thwise/kicad_tools/colour/pcbnew.png

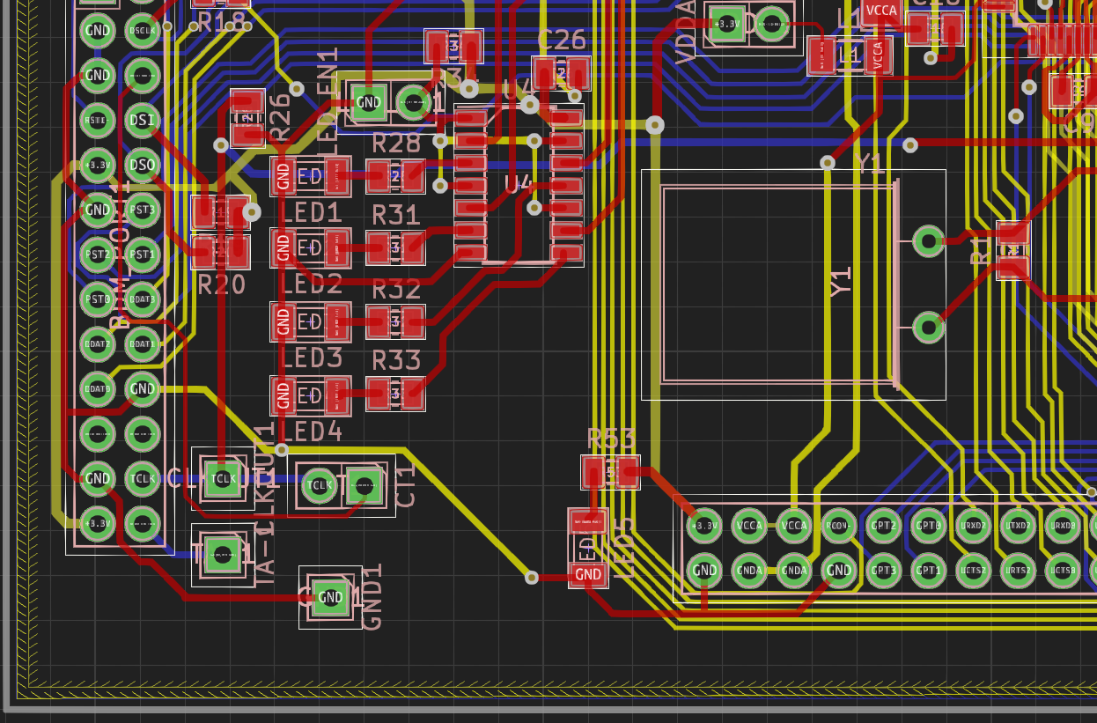
colour/pcbnew.png
