thwise/kicad_tools/colour/eeschema.png

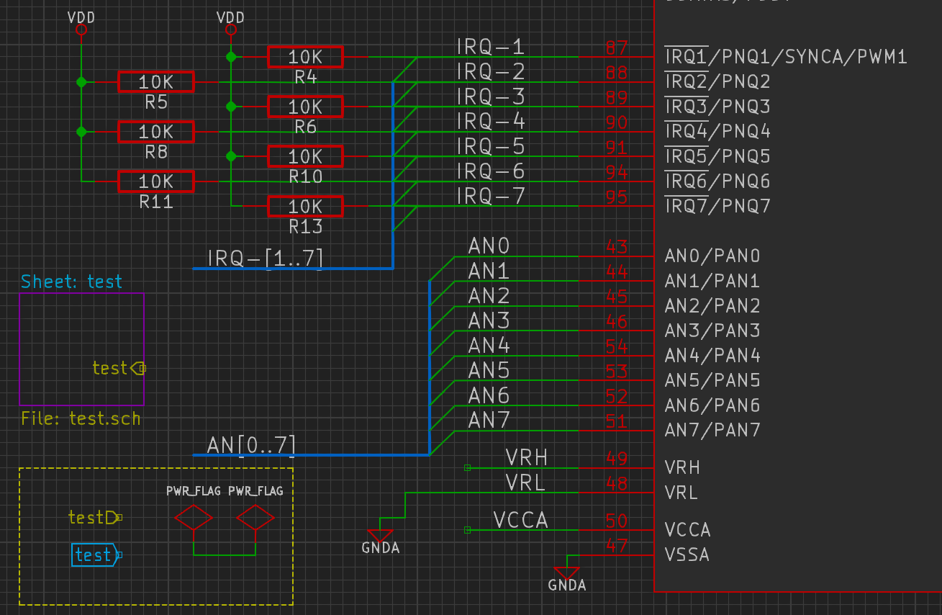
colour/eeschema.png
