thwise/kicad_tools/colour/footprint_editor.png

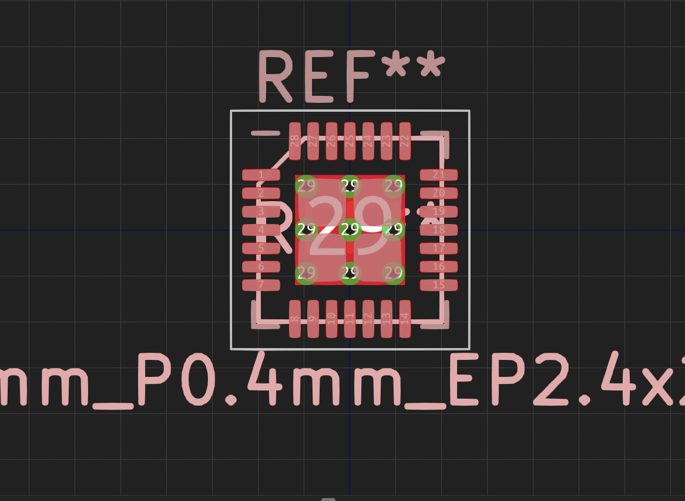
colour/footprint_editor.png
