thwise/kicad_tools/3DLib/TS-1101-C-W.stp

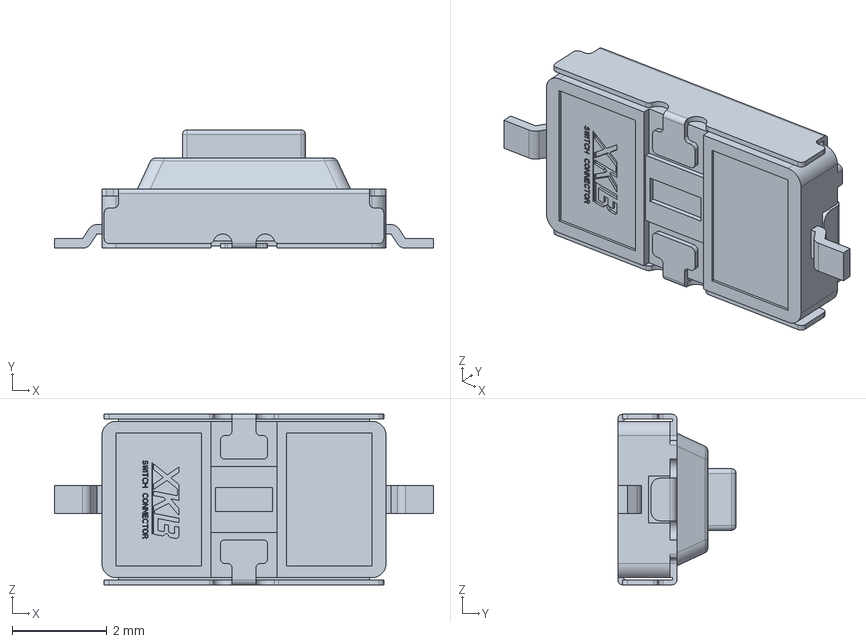
[picture p15: CAD file, 2023-06-17]
3DLib/TS-1101-C-W.stp
8.00 x 2.50 x 3.60 mm
