thwise/kicad_tools/3DLib/3362P-1-103.stp

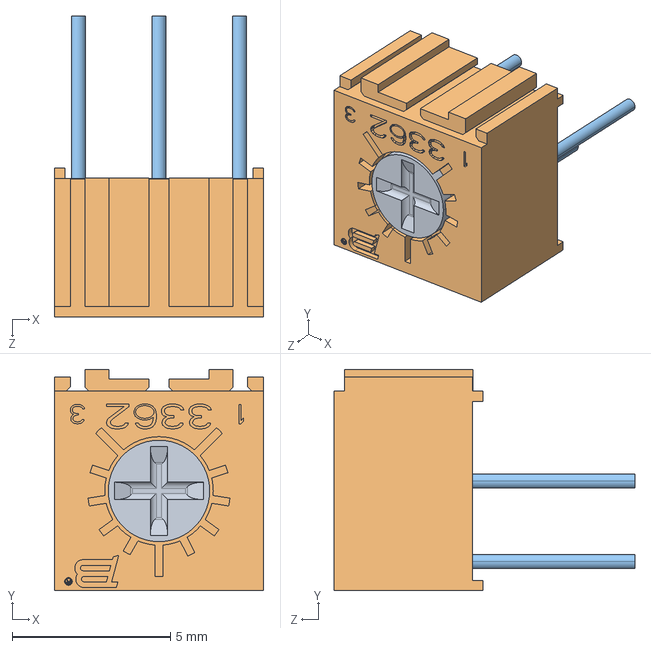
[picture p16: CAD file, 2023-06-17]
3DLib/3362P-1-103.stp
6.60 x 6.99 x 9.50 mm
