thwise/kicad_tools/3DLib/B4B-XH-A_LF__SN_.stp

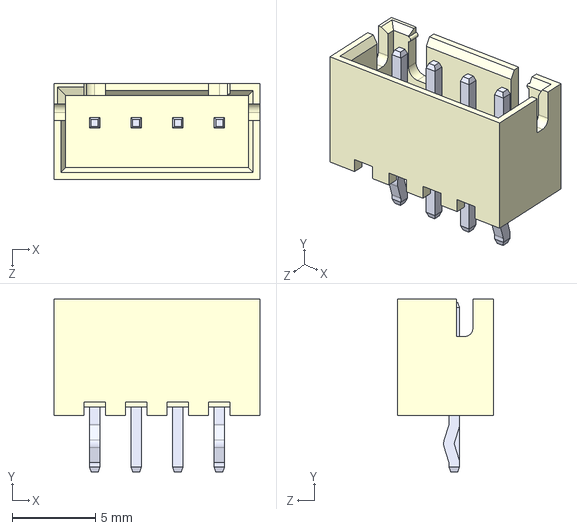
[picture p17: CAD file, 2023-06-17]
3DLib/B4B-XH-A_LF__SN_.stp
12.4 x 10.4 x 5.75 mm
B4B-XH-A(LF)(SN) - BODY
B4B-XH-A(LF)(SN) - PIN
