thwise/kicad_tools/3DLib/S8B-PH-SM4-TB_LF__SN_.stp

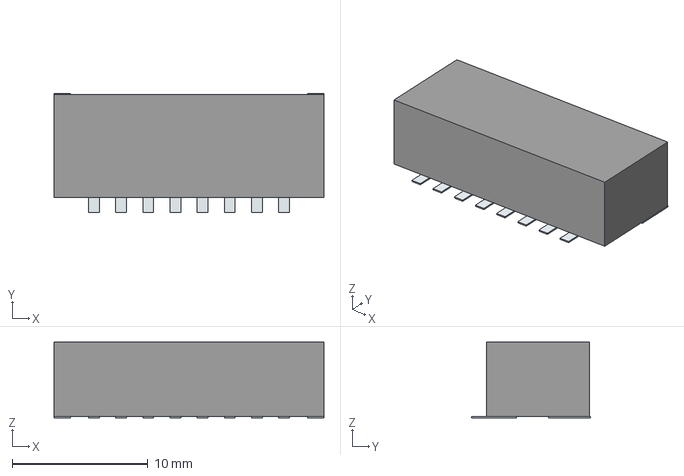
[picture p18: CAD file, 2023-06-17]
3DLib/S8B-PH-SM4-TB_LF__SN_.stp
19.9 x 8.75 x 5.60 mm
Pins
