thwise/kicad_tools/3DLib/S8411-45R.stp

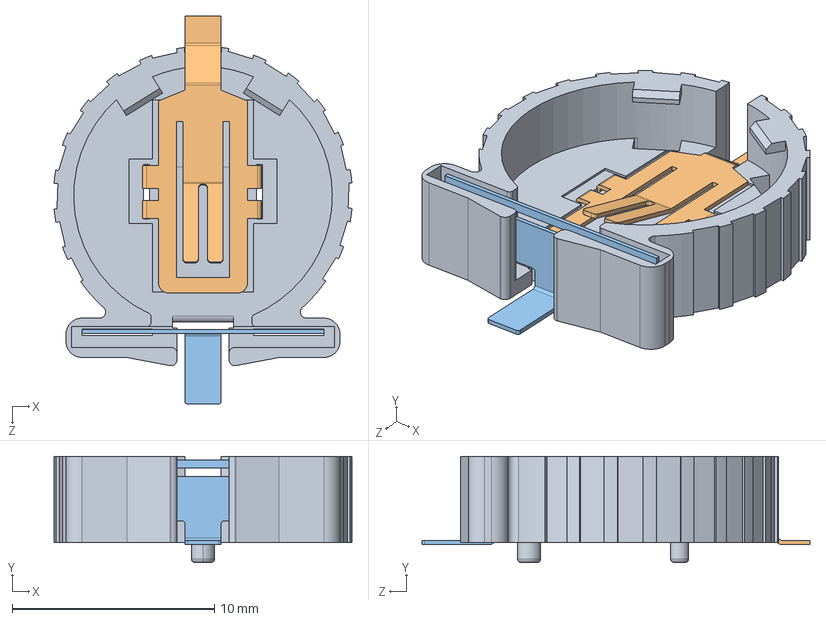
[picture p19: CAD file, 2023-06-17]
3DLib/S8411-45R.stp
14.7 x 5.25 x 19.2 mm
Holder
Lower Contact
Rear Contact
