thwise/kicad_tools/3DLib/B2B-XH-A_LF__SN_.stp

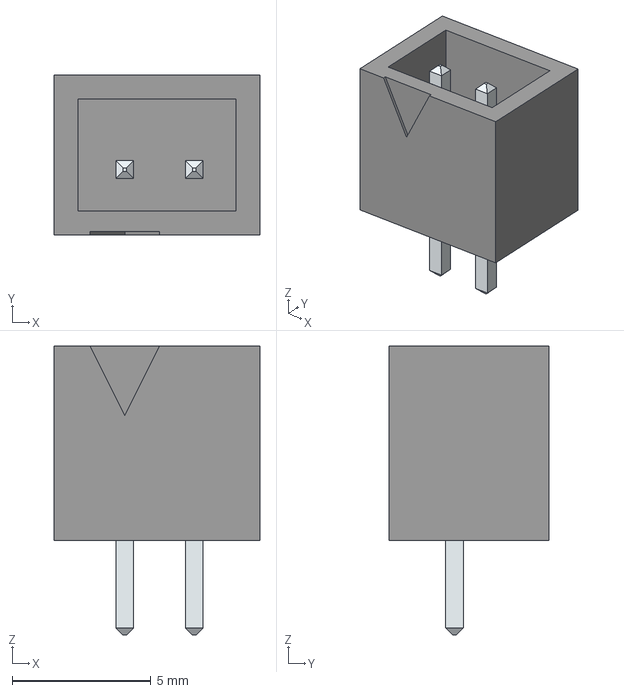
[picture p20: CAD file, 2023-06-17]
3DLib/B2B-XH-A_LF__SN_.stp
7.40 x 5.75 x 10.4 mm
LeadsArray
