thwise/kicad_tools/3DLib/DC-005-2.5A-2.5.stp

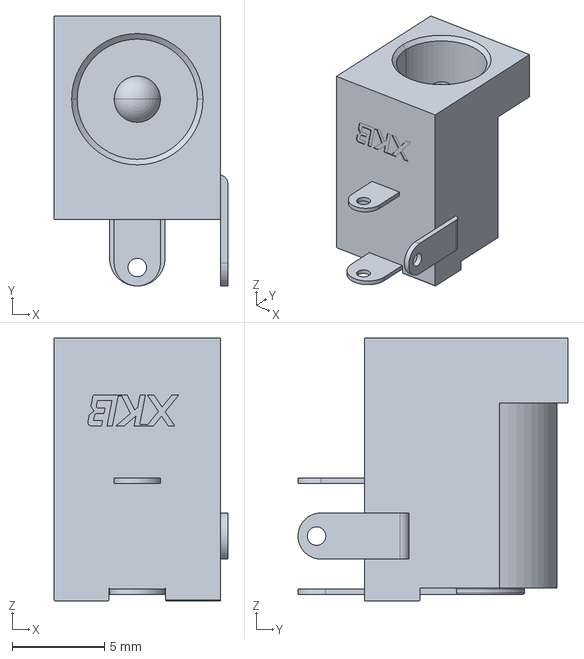
[picture p21: CAD file, 2023-06-17]
3DLib/DC-005-2.5A-2.5.stp
9.40 x 14.6 x 14.2 mm
