thwise/kicad_tools/3DLib/HX20020-8A.step

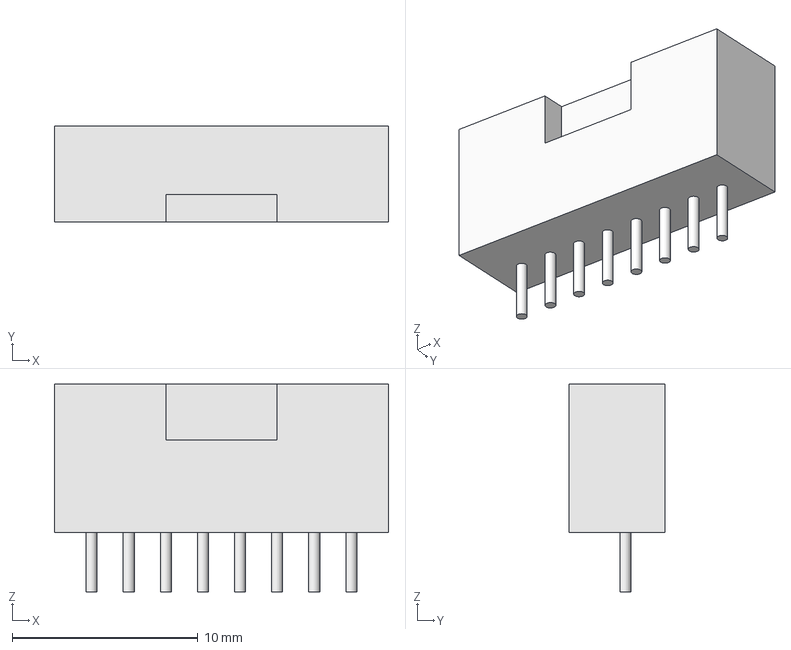
[picture p22: CAD file, 2023-06-17]
3DLib/HX20020-8A.step
18.0 x 5.20 x 11.2 mm
